pfriedel/TinyLife/IMG_0674.jpg

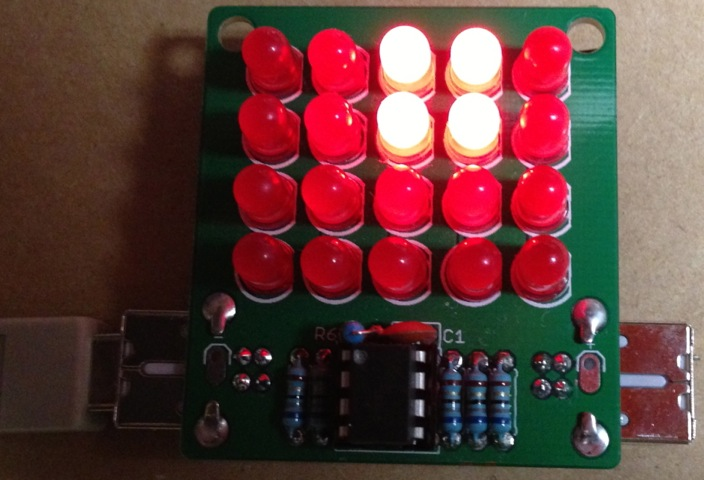
IMG_0674.jpg
