pfriedel/TinyLife/IMG_0673.jpg

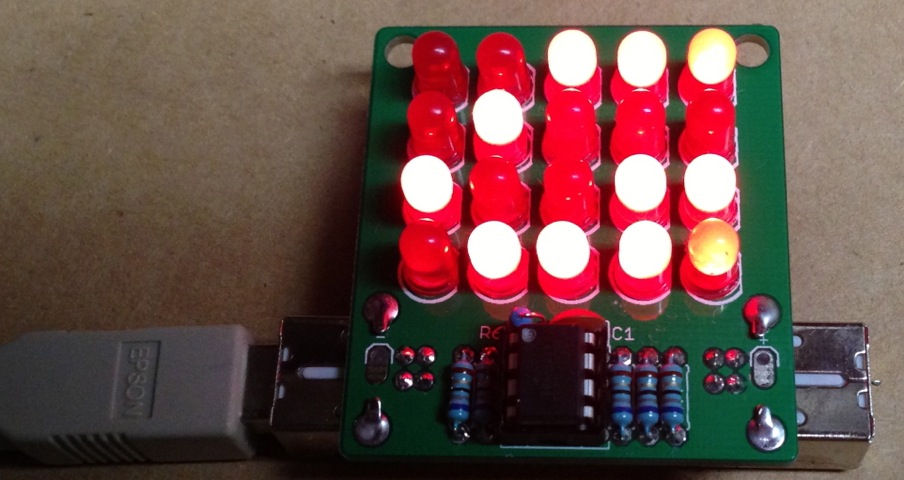
IMG_0673.jpg
